BrodieDes/honeywell-fireplace-esphome/case/preview-connector-end.png

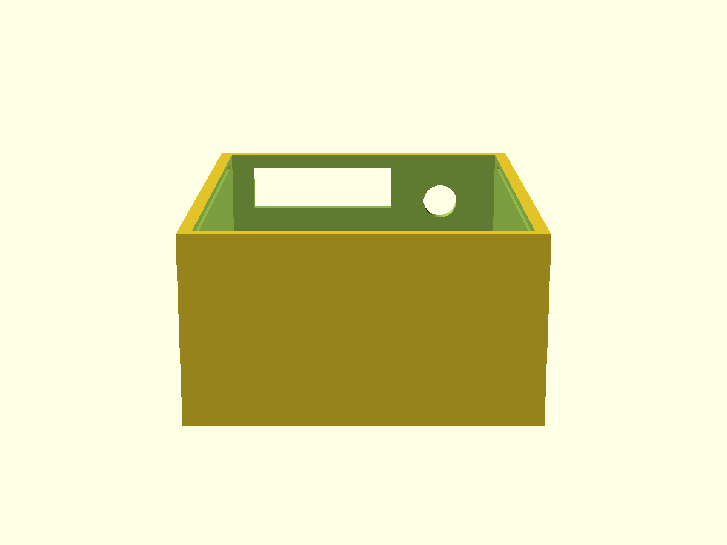
case/preview-connector-end.png
