BrodieDes/honeywell-fireplace-esphome/case/preview-lid.png

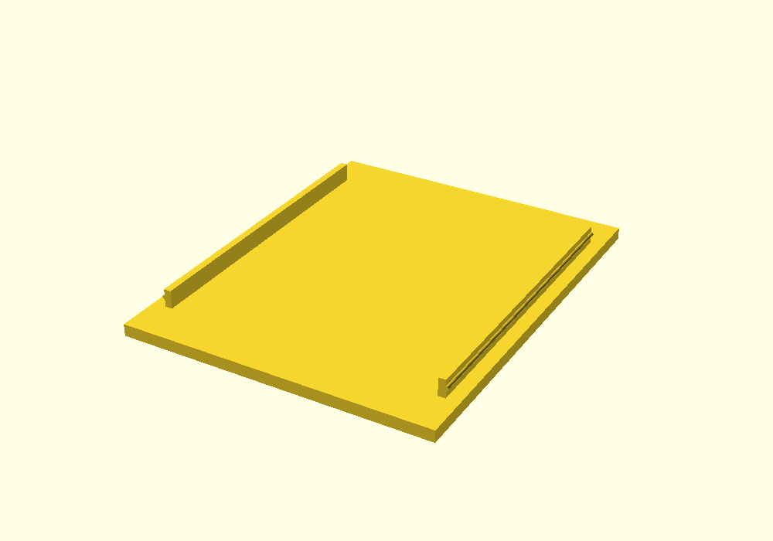
case/preview-lid.png
