BrodieDes/honeywell-fireplace-esphome/case/FireplaceRF_Case_H2D.3mf

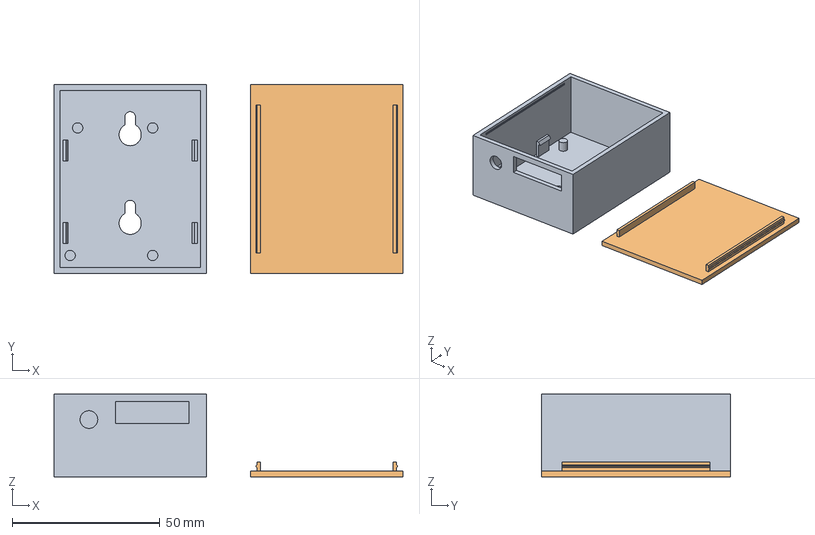
[picture p3: CAD file, 2026-11-01]
case/FireplaceRF_Case_H2D.3mf
118.2 x 64.0 x 28.0 mm
fireplace-case-base
fireplace-case-lid
