BrodieDes/honeywell-fireplace-esphome/case/fireplace-case-lid.stl

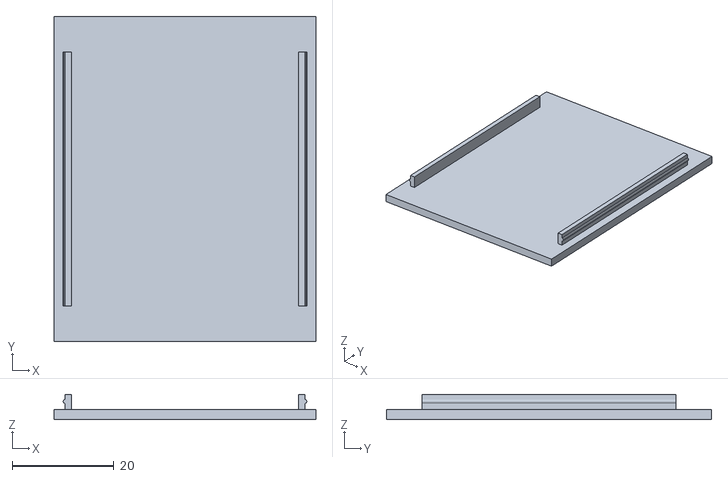
[picture p4: CAD file, 2026-11-01]
case/fireplace-case-lid.stl
51.6 x 64.0 x 5.00
