BrodieDes/honeywell-fireplace-esphome/case/fireplace-case-base.stl

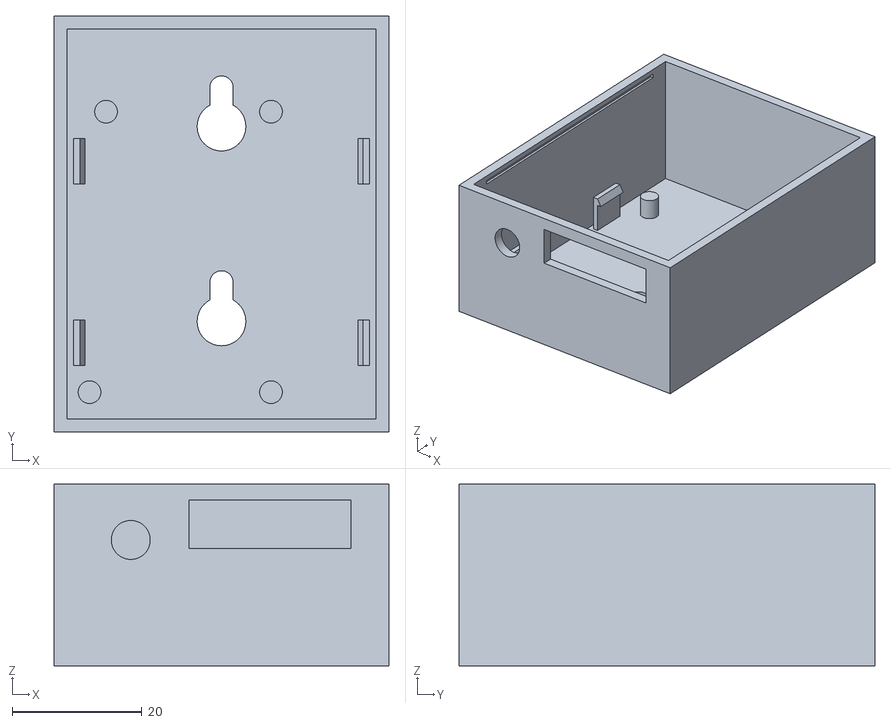
[picture p5: CAD file, 2026-11-01]
case/fireplace-case-base.stl
51.6 x 64.0 x 28.0
