BrodieDes/honeywell-fireplace-esphome/case/preview-assembly.png

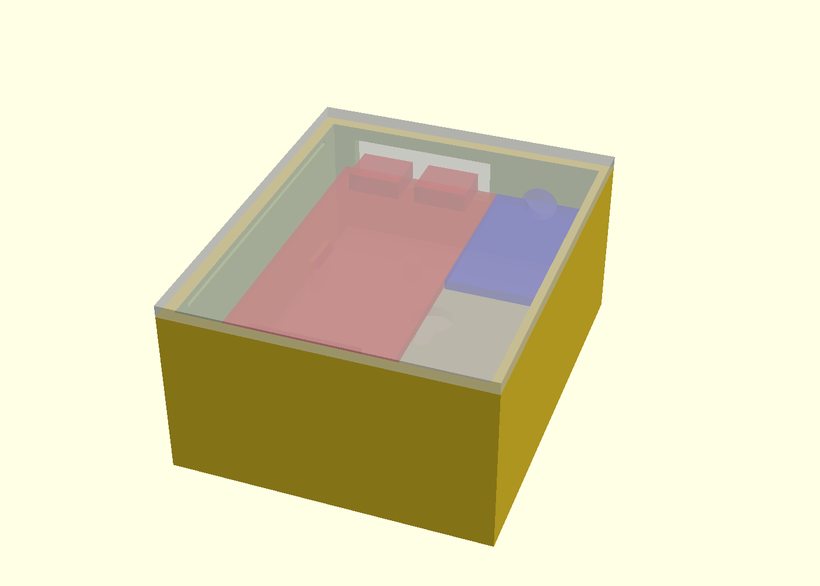
case/preview-assembly.png
