BrodieDes/honeywell-fireplace-esphome/(commit log)

2026-11-01 Initial release: Honeywell RT8220A fireplace remote for ESPHome
    ESP32-S3 + CC1101 firmware that copies the RT8220A remote (303.825 MHz),
    with on-device safety (OFF at boot, max runtime), passive sync from the
    original remote, Learn Remote, a Wi-Fi setup hotspot with fallback, and a
    printable case.
    [FireplaceRF_Case_H2D.3mf, fireplace-case-base.stl, fireplace-case-lid.stl, fireplace-case.scad]
2026-11-02 2.2.0: undo the remote's automatic resends
    The RT8220A repeats its last state about every 10 minutes and on battery
    insertion, with no button press. If the remote showed OFF and HA had
    turned the fire on, the resend put the fire out.
    The board now tells a resend (one burst, a single state, the same state
    the remote sent last) from a real press, and puts the fire back 5 s later
    unless the remote is used again. At most 8 relights an hour; a relight
    doesn't restart Max Runtime.
